Kleven2k/cis-testbench-system/figures/scope/ctrl_signal_test_1_scope/print_00.png

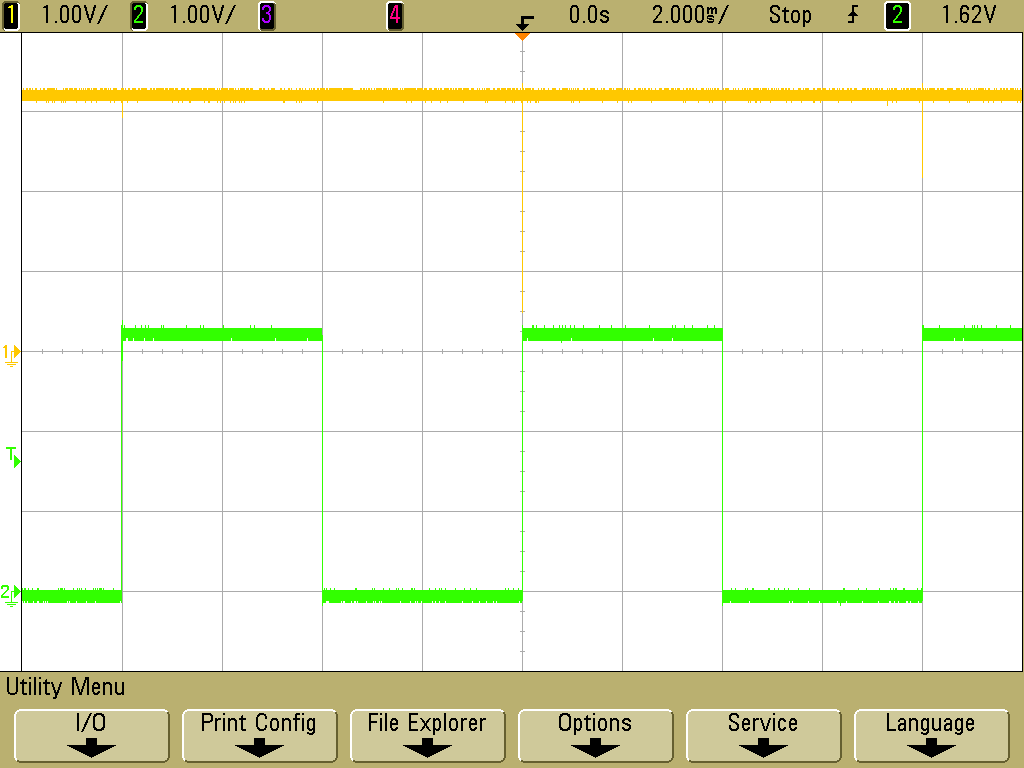
figures/scope/ctrl_signal_test_1_scope/print_00.png
