Kleven2k/cis-testbench-system/figures/scope/ctrl_signal_test_2_scope/print_02.png

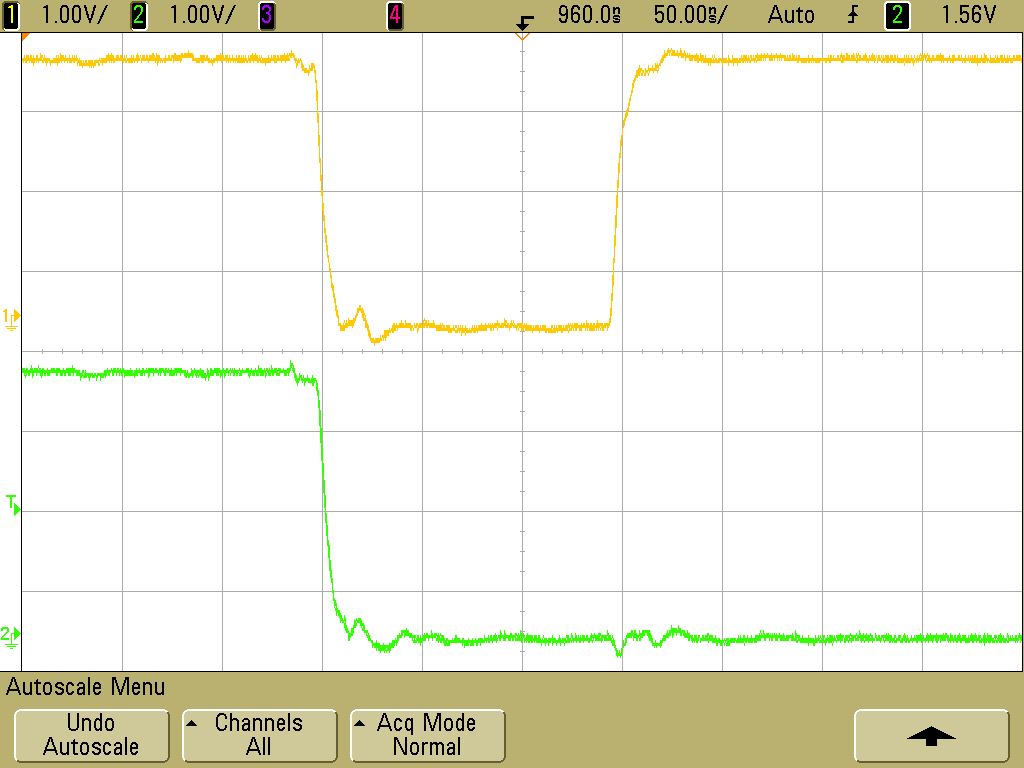
figures/scope/ctrl_signal_test_2_scope/print_02.png
