Kleven2k/cis-testbench-system/figures/scope/ctrl_signal_test_2_scope/print_04.png

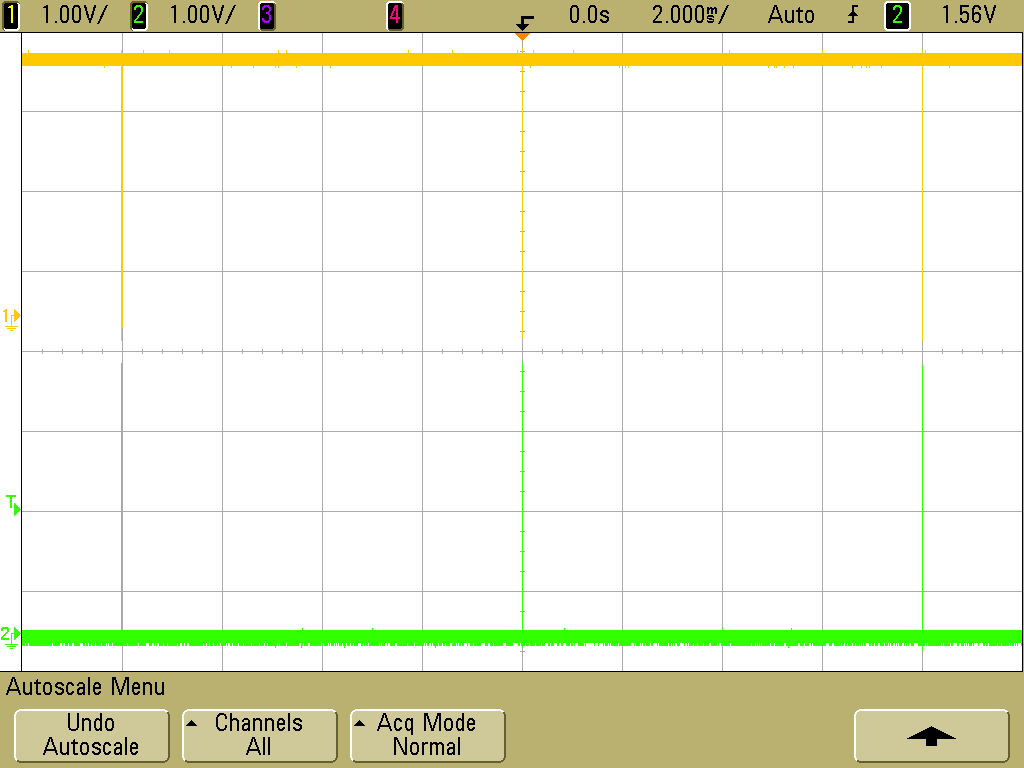
figures/scope/ctrl_signal_test_2_scope/print_04.png
