Kleven2k/cis-testbench-system/figures/scope/ctrl_signal_test_3_scope/print_06.png

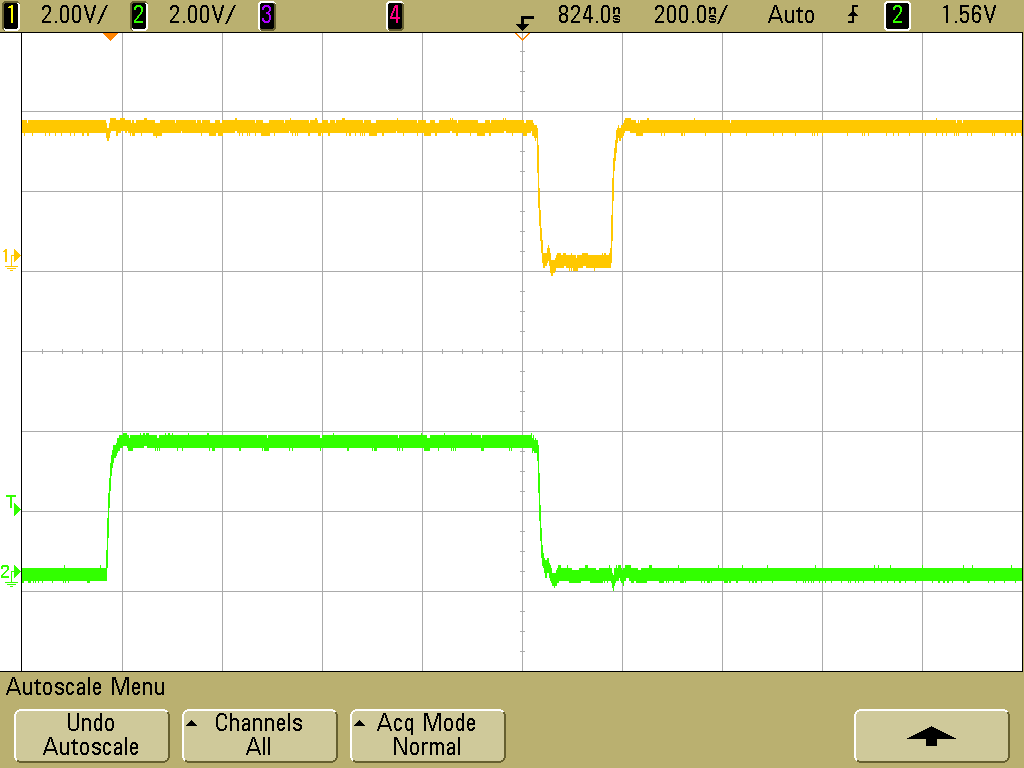
figures/scope/ctrl_signal_test_3_scope/print_06.png
