Kleven2k/cis-testbench-system/figures/scope/ctrl_signal_test_4_scope/print_08.png

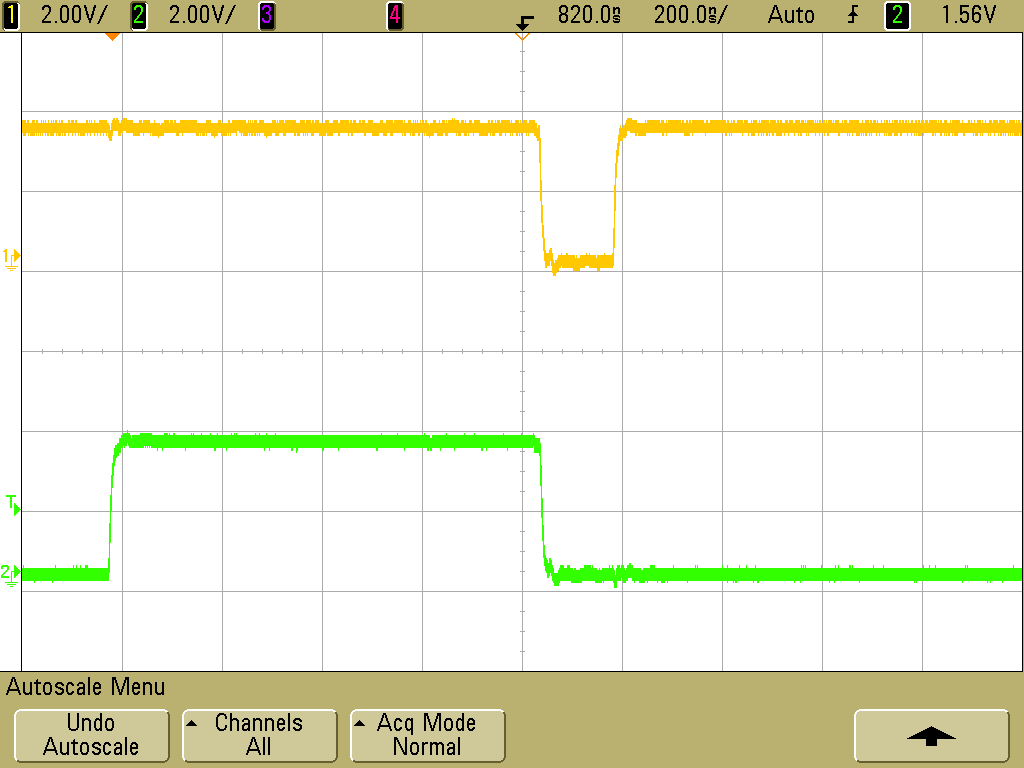
figures/scope/ctrl_signal_test_4_scope/print_08.png
