Kleven2k/cis-testbench-system/figures/scope/readout_signal_test_1_scope/print_10.png

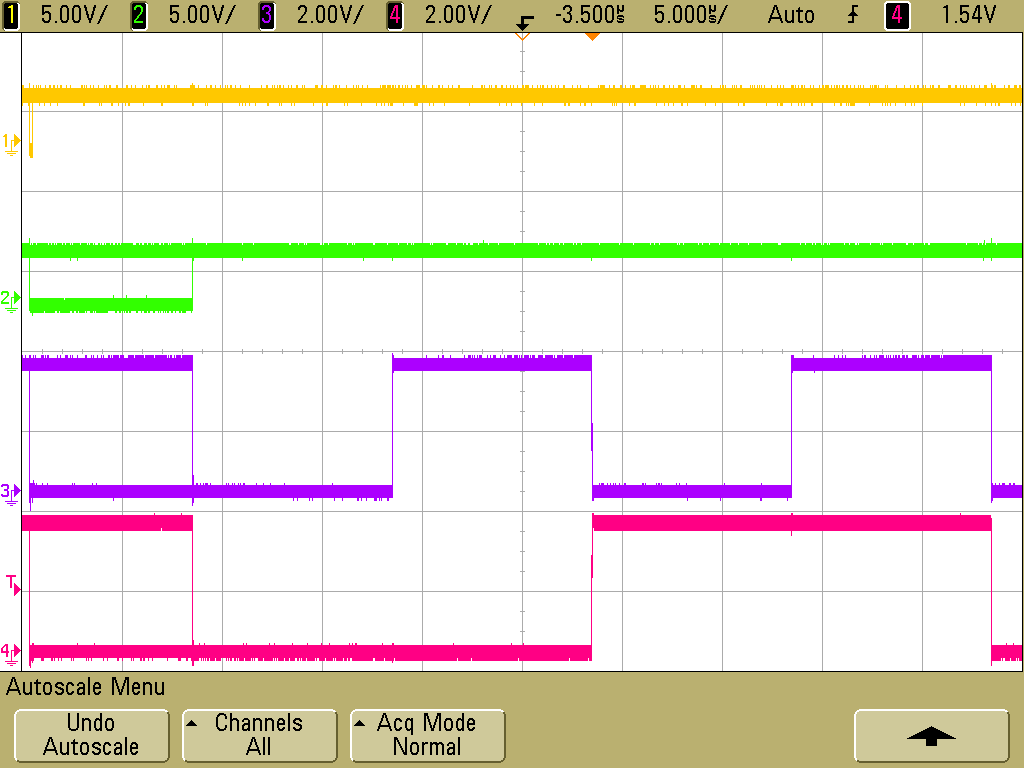
figures/scope/readout_signal_test_1_scope/print_10.png
