Kleven2k/cis-testbench-system/figures/scope/readout_signal_test_1_scope/print_12.png

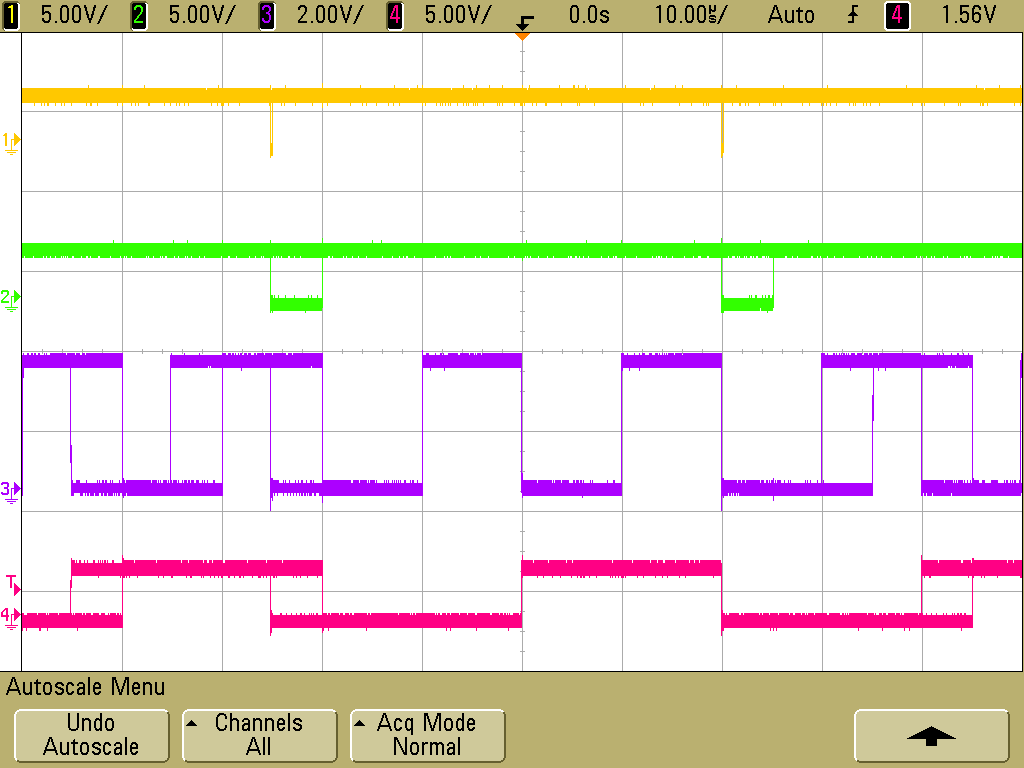
figures/scope/readout_signal_test_1_scope/print_12.png
