Kleven2k/cis-testbench-system/figures/scope/readout_signal_test_2_scope/print_13.png

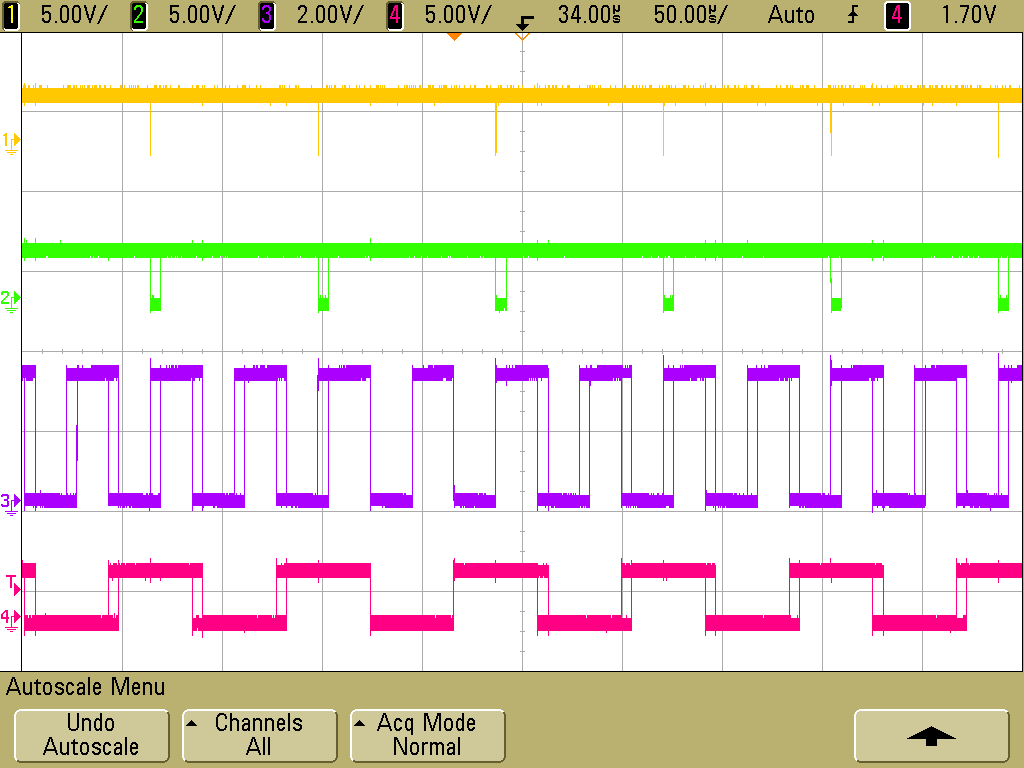
figures/scope/readout_signal_test_2_scope/print_13.png
