Kleven2k/cis-testbench-system/figures/scope/readout_signal_test_3_scope/print_15.png

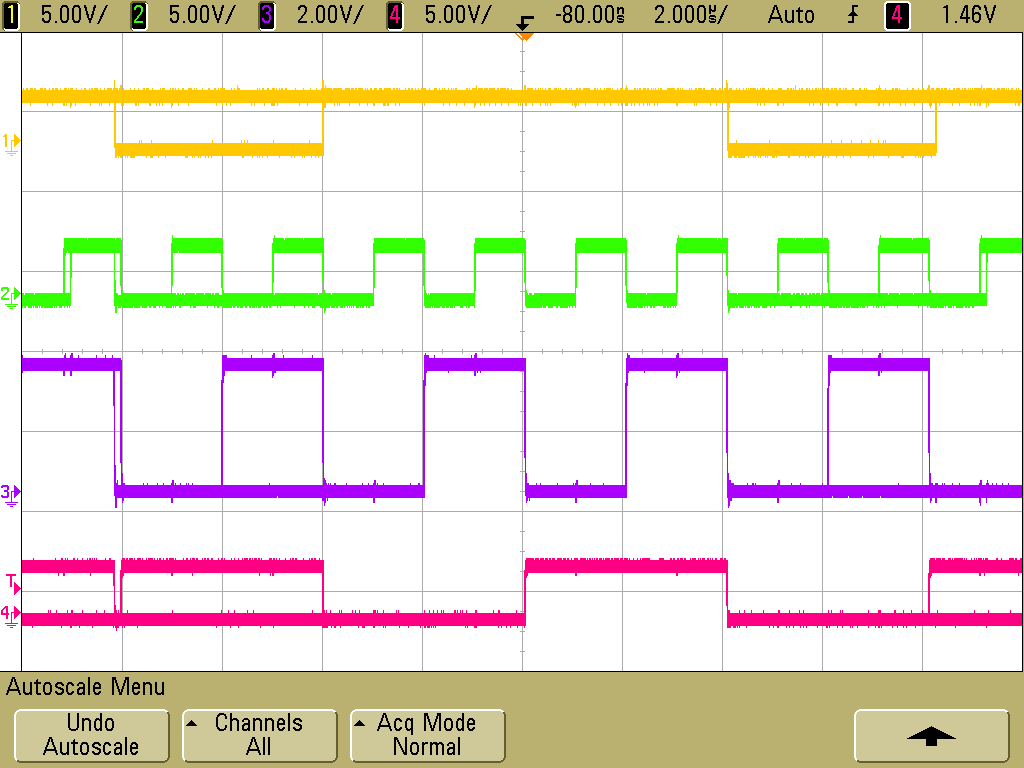
figures/scope/readout_signal_test_3_scope/print_15.png
