Kleven2k/cis-testbench-system/figures/scope/readout_signal_test_4_scope/ax/print_03.png

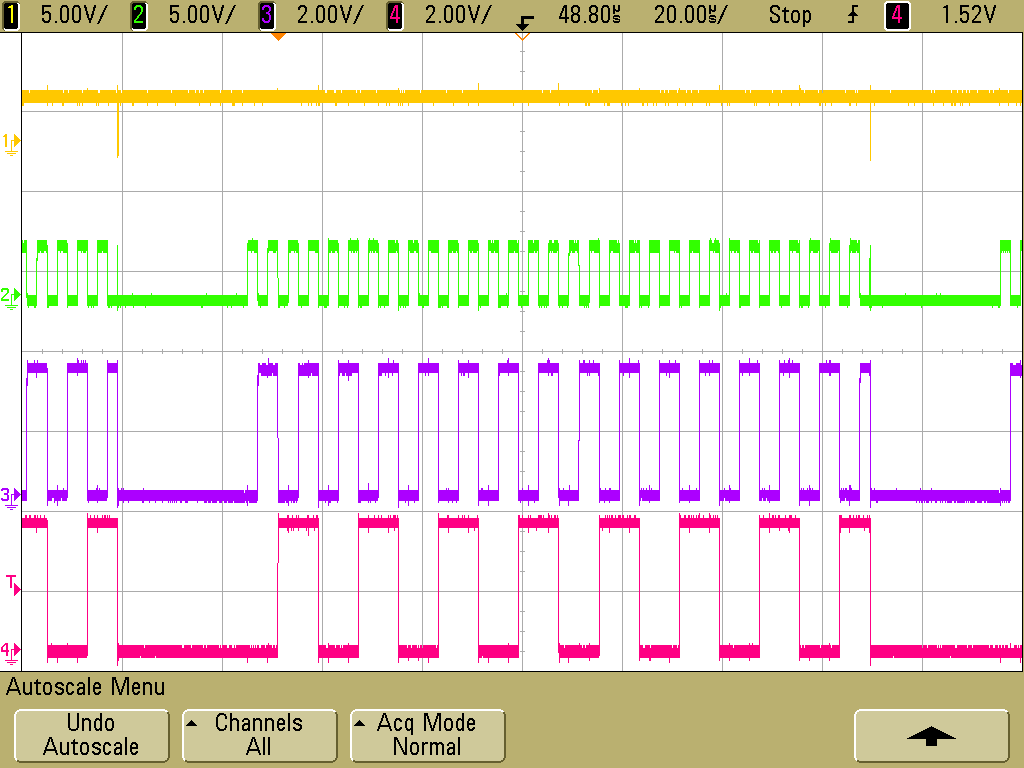
figures/scope/readout_signal_test_4_scope/ax/print_03.png
