Kleven2k/cis-testbench-system/figures/scope/readout_signal_test_4_scope/ay/print_00.png

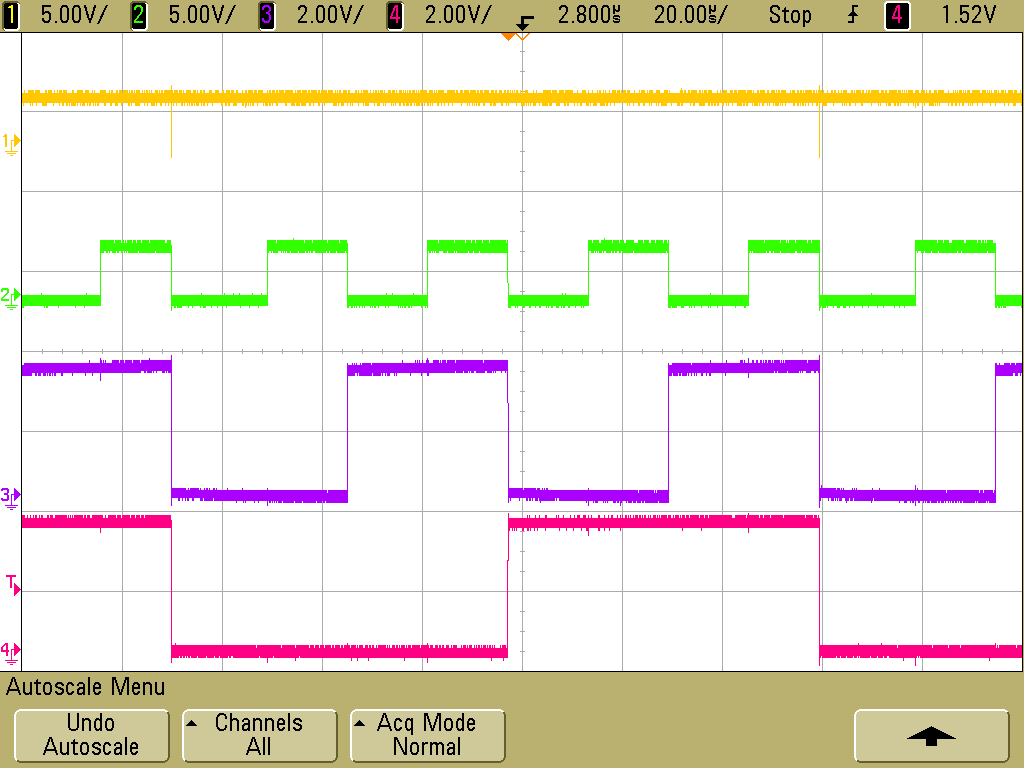
figures/scope/readout_signal_test_4_scope/ay/print_00.png
