Kleven2k/cis-testbench-system/figures/scope/readout_signal_test_4_scope/ay/print_01.png

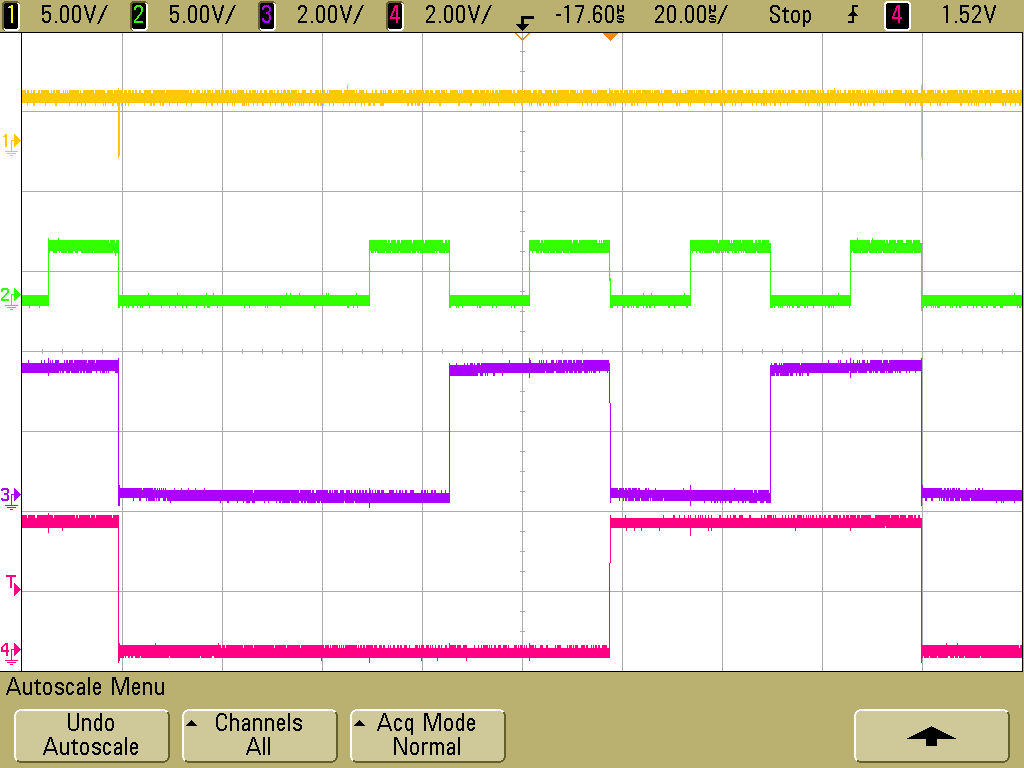
figures/scope/readout_signal_test_4_scope/ay/print_01.png
