Kleven2k/cis-testbench-system/figures/scope/readout_signal_test_5_scope/ax/print_04.png

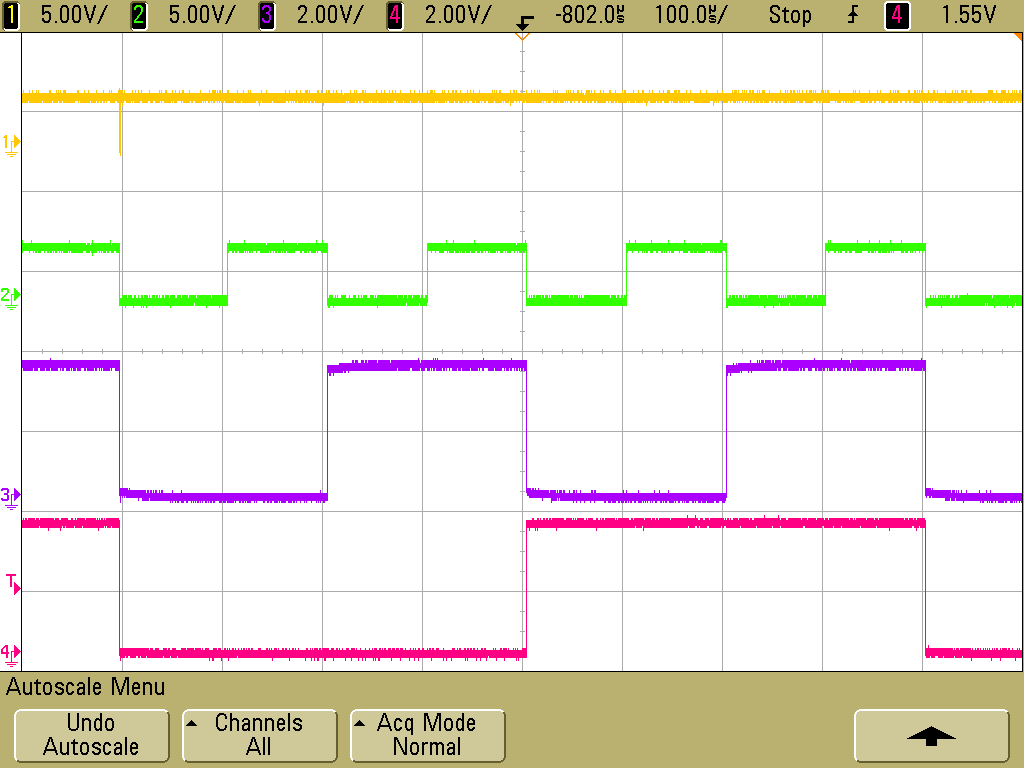
figures/scope/readout_signal_test_5_scope/ax/print_04.png
