Kleven2k/cis-testbench-system/figures/scope/readout_signal_test_5_scope/ax/print_05.png

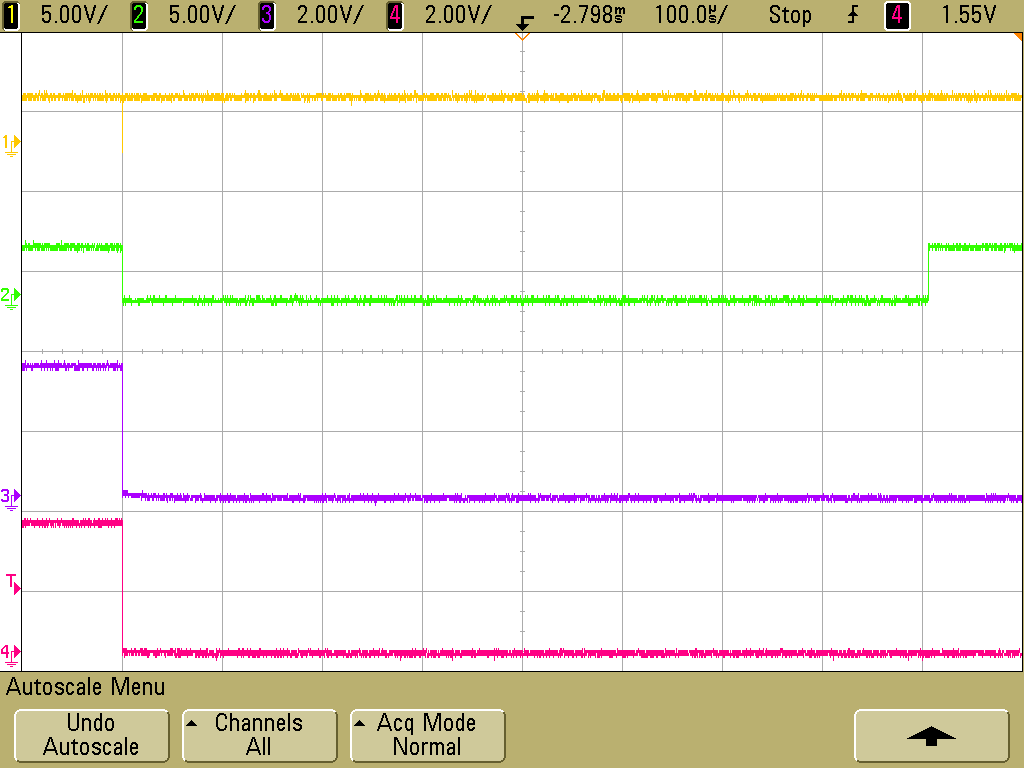
figures/scope/readout_signal_test_5_scope/ax/print_05.png
