Kleven2k/cis-testbench-system/figures/scope/readout_signal_test_5_scope/print_06.png

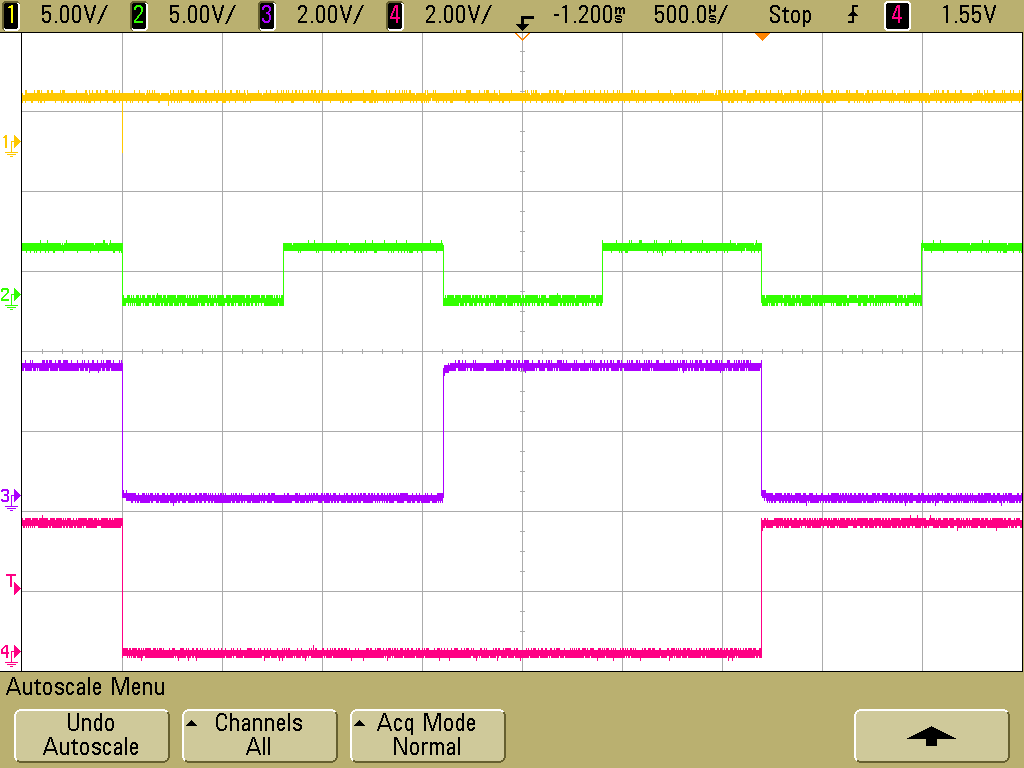
figures/scope/readout_signal_test_5_scope/print_06.png
