Kleven2k/cis-testbench-system/figures/scope/readout_signal_test_5_scope/print_07.png

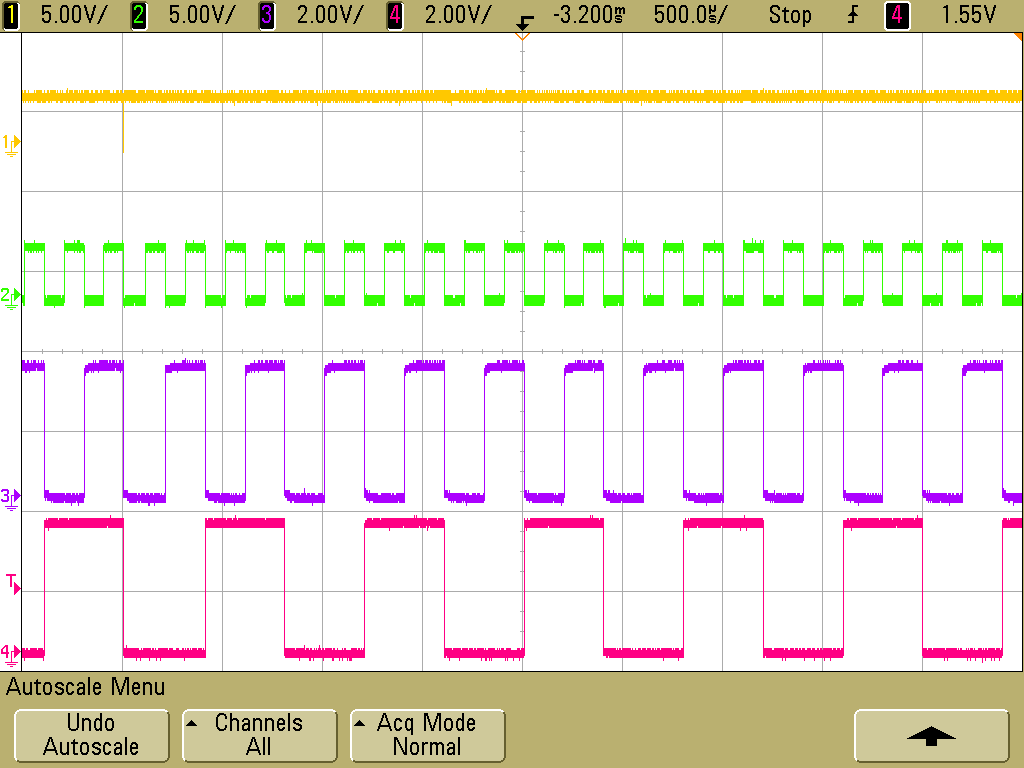
figures/scope/readout_signal_test_5_scope/print_07.png
