Kleven2k/cis-testbench-system/figures/scope/readout_ax_ay_test_1_scope/ay.png

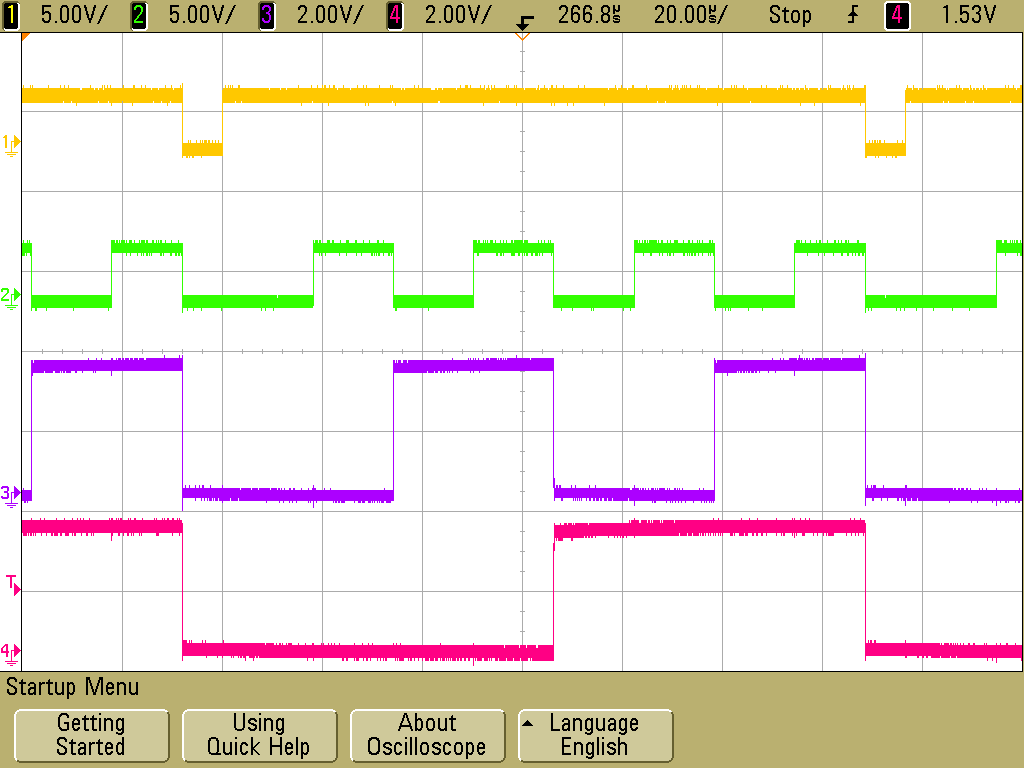
figures/scope/readout_ax_ay_test_1_scope/ay.png
