Kleven2k/cis-testbench-system/hdl/rtl/clock/clk_720p.sv

`default_nettype none
`timescale 1ns / 1ps

module clk_720p (
    input wire logic clk_100m,         // input clock (100 MHz)
    input wire logic rst,              // reset
    output     logic clk_pix,          // pixel clock
    output     logic clk_pix_5x,       // 5x clock for 10:1 DDR SerDes
    output     logic clk_pix_locked    // pixel clock locked?
    );

    localparam MULT_MASTER = 37.125;  // master clock multiplier
    localparam DIV_MASTER = 5;        // master clock divider
    localparam DIV_5X = 2.0;          // 5x pixel clock divider
    localparam DIV_1X = 10;           // pixel clock divider
    localparam IN_PERIOD = 10.0;      // period of master clock in ns (10 ns == 100 MHz)

    logic feedback;             // internal clock feedback
    logic clk_pix_unbuf;        // unbuffered pixel clock
    logic clk_pix_5x_unbuf;     // unbuffered 5x pixel clock
    logic locked;               // unsynced lock signal

    MMCME2_BASE #(
        .CLKFBOUT_MULT_F(MULT_MASTER),
        .CLKIN1_PERIOD(IN_PERIOD),
        .CLKOUT0_DIVIDE_F(DIV_5X),
        .CLKOUT1_DIVIDE(DIV_1X),
        .DIVCLK_DIVIDE(DIV_MASTER)
    ) MMCME2_BASE_inst (
        .CLKIN1(clk_100m),
        .RST(rst),
        .CLKOUT0(clk_pix_5x_unbuf),
        .CLKOUT1(clk_pix_unbuf),
        .LOCKED(locked),
        .CLKFBOUT(feedback),
        .CLKFBIN(feedback),
        /* verilator lint_off PINCONNECTEMPTY */
        .CLKOUT0B(),
        .CLKOUT1B(),
        .CLKOUT2(),
        .CLKOUT2B(),
        .CLKOUT3(),
        .CLKOUT3B(),
        .CLKOUT4(),
        .CLKOUT5(),
        .CLKOUT6(),
        .CLKFBOUTB(),
        .PWRDWN()
        /* verilator lint_on PINCONNECTEMPTY */
    );

    // explicitly buffer output clocks
    BUFG bufg_clk(.I(clk_pix_unbuf), .O(clk_pix));
    BUFG bufg_clk_5x(.I(clk_pix_5x_unbuf), .O(clk_pix_5x));

    // ensure clock lock is synced with pixel clock
    logic locked_sync_0;
    always_ff @(posedge clk_pix) begin
        locked_sync_0 <= locked;
        clk_pix_locked <= locked_sync_0;
    end
endmodule
