Kleven2k/cis-testbench-system/hdl/rtl/display/OLED/delay_ms.v

`timescale 1ns / 1ps
//////////////////////////////////////////////////////////////////////////////////
// Company: DigilentInc
// Engineer: Arthur Brown
// 
// Create Date: 09/22/2016 09:58:43 AM
// Module Name: Delay
// Project Name: OLED Demo
// Target Devices: Nexys Video
// Description: Handles N-millisecond delays. On start flag, assert done after delay_time_ms milliseconds.
// 
// Revision:
// Revision 0.01 - File Created
// Additional Comments:
// 
//////////////////////////////////////////////////////////////////////////////////


module delay_ms (
    input        clk,
    input [11:0] delay_time_ms,
    input        delay_start,
    output       delay_done
);
    localparam  Idle = 0,
                Hold = 1,
                Done = 2;
    localparam  MAX = 17'd99999;
    reg [1:0] state=Idle;
    reg [11:0] stop_time=0, ms_counter=0;
    reg [16:0] clk_counter=0;
    
    assign delay_done = (state == Idle && delay_start == 1'b0) ? 1'b1 : 1'b0;
    
    always@(posedge clk)
        case (state)
        Idle: begin
            stop_time <= delay_time_ms;
            if (delay_start == 1'b1)
                state <= Hold;
        end
        Hold:
            if (ms_counter == stop_time && clk_counter == MAX)
                if (delay_start == 1'b1)
                    state <= Done;
                else
                    state <= Idle;
        Done:
            if (delay_start == 1'b0)
                state <= Idle;
        endcase
        
    always@(posedge clk)
        if (state == Hold)
            if (clk_counter == MAX) begin
                clk_counter <= 'b0;
                if (ms_counter == stop_time)
                    ms_counter <= 'b0;
                else
                    ms_counter <= ms_counter + 1'b1;
            end
            else
                clk_counter <= clk_counter + 1'b1;
        else begin
            clk_counter <= 'b0;
            ms_counter <= 'b0;
        end
endmodule
