Kleven2k/cis-testbench-system/(commit log)

2026-03-22 Initial commit: FPGA CIS testbench system
    FPGA-based testbench for CMOS image sensor characterization on the
    Digilent Nexys Video board. Includes RTL source (SystemVerilog/VHDL),
    constraints, simulation testbenches, Python GUI, and thesis scaffold.
2026-04-30 Fix VHDL-93 compatibility and add runtime active_cols/active_rows ports
    [sensor_ctrl.vhd]
2026-04-30 Add ACTIVE_COLS/ROWS registers, remap switches, move pixel base to 0x0A
2026-04-30 Fix timing: replace digit() dividers with BCD pipeline, expand to 4 rows
    [OLED_master.v]
2026-04-30 Fix timing: split into two registered pipeline stages, parametric decoder
    [simple_pixel.sv]
2026-04-30 Fix timing closure: pipeline display path and sequential min/max reductionFix timing closure: pipeline display path and sequential min/max reduction
    [cis_system_top.sv]
